gvsolgryn/HYK_AMP_Converter/docs/DUDU7_i40_SPDIF_TX_Rev1_PCB_Mechanical_Handoff_20261113.md

# DUDU7 / FYT7862 → Hyundai i40 S/PDIF TX Rev.1
## PCB · 기구 인계 문서 — 2026-11-13

다음 에이전트가 이 문서와 `AGENTS.md`만 읽고 PCB 작업을 시작할 수 있도록 정리한 문서다.
설계 판단의 최우선 기준은 여전히 `docs/DUDU7_i40_SPDIF_TX_Rev1_BOM_for_KiCad_Agent.md` §9 Decision log다. 이 문서와 충돌하면 Decision log가 우선이다.

---

## 1. 현재 상태 한눈에 보기

| 항목 | 상태 |
|---|---|
| 회로도 | Rev.1 부품 54개 배치·배선 완료, **ERC 0건**, 넷리스트 핀 단위 대조 일치 |
| 레이아웃 | 4개 블록(1 POWER / 2 INPUT / 3 DRIVER / 4 OUTPUT) 점선 프레임, 블록 간 로컬 라벨 |
| 커넥터 핀 | J3 `1=ACC_IN, 2=GND` (결정 #15) · J2 `1=SPDIF−, 2=SPDIF+, 3=GND` (결정 #23) |
| 외함 | **케이스포유 RT-7511** (75 × 30.9 × 110 mm) — 결정 #16, 치수는 §3 |
| BNC 장착 | J1을 PCB 앞 가장자리에 두고 **나사부를 앞판 구멍으로 빼서 너트로 고정** — 결정 #17 |
| PCB | **배치·배선 완료**, DRC 0 · 회로도 불일치 0 (결정 #24). §5 체크리스트 참고 |
| 커밋 | 2026-11-13 PCB 작업까지 커밋·푸시 (case 도면은 저작권 때문에 제외, §3.4) |

---

## 2. 2026-11-13 세션에서 바뀐 것 (시간순)

1. README를 Rev.1 기준으로 재작성. `opencode.json` 삭제(OpenCode 미사용).
2. MCP 서버를 **mixelpixx/KiCAD-MCP-Server v2.9.0**으로 교체. `~/MCP/KiCAD-MCP-Server`에 설치, omp 사용자 설정 `~/.omp/agent/mcp.json`에 `KICAD_MCP_OPERATING_MODE=readonly`로 등록. 등록 방법은 README "MCP 자동화".
3. 배선 가이드(HTML·MD)를 결정 로그와 맞춤: `L1→FL1`, `+3V3→+3.3V`, D1 `1=K/2=A`, FL1 핀 `1↔4 / 2↔3`, R6 `CMP_OUT↔SPDIF_AC` DNP. ASCII 그림을 새로 그리고 넷 라벨을 `[NET]` 표기로 통일.
4. **D2 TVS를 D1 앞(`ACC_FUSED`)으로 확정** — 결정 #14.
5. 사용자가 회로도 배선 완료 → 넷리스트 대조로 검증.
6. ERC 수정: U2(TPS7B8350 심볼) 핀 타입 `IN/GND=power_in, OUT=power_out`, U4(MAX3295 심볼) `DI/DE=input, Y/Z=output`. 라이브러리 파일과 회로도 내장 캐시 둘 다 수정. PWR_FLAG `#FLG01`(VIN_PROTECTED), `#FLG02`(GND).
7. 회로도 레이아웃 정리(와이어·라벨 재작성, 넷리스트 동일 확인).
8. J2/J3 핀 순서를 "이름 순서, GND 마지막"으로 변경 — 결정 #15.
9. 외함을 Hammond 1455C1201BK → **케이스포유 RT-75(RT-7511)**로 변경 — 결정 #16.
10. BNC를 앞판 관통 고정 방식으로 정함 — 결정 #17.

백업(깃 미포함, `backup/` 로컬): `20261113_011734`(배선 직후) · `20261113_012318`(사용자 최종 수정) · `20261113_012744`(ERC 수정 후) · `20261113_014944`(레이아웃 정리 후).

---

## 3. 외함 — 케이스포유 RT-75 (RT-7511)

출처: 케이스포유 도면 `RT-7511.pdf / .dwg / .STEP` (2011-07-27, 사용자가 `references/case_file/RT_7511.zip`, `RT_7590.zip`으로 보관). 아래 치수는 도면 숫자를 그대로 옮기거나(■) 도면 축척으로 계산한 값(□)이다.

### 3.1 외형

| 항목 | 값 | 출처 |
|---|---|---|
| 전체 | 75 (W) × 30.9 (H) × 110 (L) mm | ■ |
| 본체(압출, AL6061, 아노다이징) | 74.9 × 30.5 × **107** mm | ■ |
| 전·후면 판넬(AL5052, 아노다이징) | 75 × 30.9 × **1.5** mm, 본체 양 끝에 볼트 체결 | ■ |
| 판넬 나사 구멍 | 4개, 중심 간격 **67.2 (가로) × 22.8 (세로)**, 판넬 중앙 기준 대칭 | ■ |
| RT-7590 | 같은 단면, 본체 87 mm, 전체 90 mm | ■ |

### 3.2 PCB 장착 단면 (RT-7511 단면도)

```text
          ┌──────────────── 75 ────────────────┐
     ─ ─  ╭──◎────────────────────────────◎──╮   ◎ = 판넬 나사 보스(코너 4개, 67.2 × 22.8)
     ↑    │                                    │
     │    │        PCB 위 여유 ≈ 19.4 mm □      │  25.5 = 내부 높이 ■
 30.9│    │                                    │
     │  ══╪════════════ PCB 1.6T ═════════════╪══ 홈 간격 1.70 ■ / 홈 바닥 간 폭 70.5 (STEP) · 내벽 69.7 ■
     │    │        PCB 아래 4.5 mm ■            │
     ↓    ╰──◎────────────────────────────◎──╯
```

| 항목 | 값 | 출처 |
|---|---|---|
| PCB 두께 | 1.6 mm (홈 1.70) | ■ |
| PCB 폭 한계 | **홈 바닥 간 70.5 mm** (STEP 실측, 홈 깊이는 내벽에서 2.0 mm). 도면의 69.7은 PCB 위쪽 **내벽 간 폭**. 케이스포유 PCB 참고도는 70.00 × 107.00 | ■ STEP |
| **PCB 외형** | **69.5 × 100.0 mm** (홈 바닥 70.5 대비 양쪽 0.5 mm 여유, 홈 물림 1.5 mm. 길이는 JLCPCB 특가 한도 102 mm 이하 — 107로 하면 추가금) | 결정 #18 (#16의 107.0 대체) |
| PCB 아래면 ↔ 내부 바닥 | **4.5 mm** | ■ |
| 내부 높이 | 25.5 mm | ■ |
| PCB 윗면 위 여유 | 내부 천장까지 **19.35 mm** (중앙부) | ■ STEP |
| PCB 윗면 높이(외부 바닥 기준) | **8.65 mm** (외부 바닥 −15.0, PCB 윗면 −6.35, STEP 좌표) | ■ STEP |

**STEP 실측 (2026-11-13, `RT-7511.STEP` 단면, PCB를 홈 중앙 −7.95 ~ −6.35에 둔 기준)**. d = PCB 긴 변에서 안쪽으로 잰 거리.

| 구역 | 범위 | 제약 |
|---|---|---|
| 홈 물림 | d < **1.5 mm** (양쪽) | PCB가 홈에 들어가는 부분. 부품·노출 동박 금지. 구리–가장자리 클리어런스 **2.0 mm 권장** (홈 안 알루미늄과 접촉 방지) |
| 윗면 홈 턱 | d < 1.5 mm는 높이 1.55 mm까지, d < 0.9 mm는 2.55 mm까지 벽 | 위 홈 물림 금지로 해결 |
| 윗면 나사 보스 | d < **3.9 mm** | 부품 높이 **≤ 15.2 mm** (보스 하단 = PCB 위 15.25 mm). 그 안쪽은 19.35 mm |
| 아랫면 홈 턱 | d < 1.5 mm | 홈 아래 면 (PCB가 얹힘) |
| 아랫면 나사 보스 | d < 2.35 mm → 리드 돌출 **≤ 1.8 mm**, d < 3.9 mm → **≤ 3.0 mm** | 그 안쪽은 바닥까지 4.55 mm |

KiCad 참조: 풋프린트 `Case_RT75:CASE_RT7511` (패드 없음, board-only, BOM 제외). 기판 앞 가장자리 중앙에 0°로 두면 3D 뷰어에 케이스가 겹쳐 보이고, `Dwgs.User`에 판넬 위치·홈 1.5 mm(점선)·보스 3.9 mm(점선)가 그려진다. STEP 경로는 `${KIPRJMOD}/references/case_file/RT_7511/RT-7511.STEP`(로컬 전용).

### 3.3 PCB 설계 제약 (외함에서 나온 것)

- **길이 100 mm (본체 107 mm보다 7 mm 짧음)**: PCB **앞 가장자리를 본체 앞끝에 맞추고**(J1 나사부가 앞판 관통, 결정 #17), 뒤쪽 약 7 mm는 뒷판까지 빈 공간으로 둔다. PCB는 홈과 J1 판넬 너트로 위치가 정해지므로 뒤가 떠 있어도 된다. 이 공간은 J2·J3 플러그·전선용으로 쓴다.
- **아래면**: Bottom에 부품 없음(전 부품 Top 규칙 유지). THT 리드는 **1.5 mm 이하로 자르면 모든 위치에서 안전** (긴 변 3.9 mm 이내는 위 표 제약).
- **긴 변**: 부품 코트야드는 긴 변에서 **2.0 mm 이상**, 높이 15.2 mm 초과 부품(현재 없음)은 3.9 mm 이상 떨어뜨린다. 현재 가장 높은 부품: J1 12.5, F1+퓨즈 ≈ 13, C1 11 mm.
- **높이 예산 19.4 mm**: BNC, 퓨즈홀더+퓨즈, TSR 모듈, VH 커넥터, C1 전해(세워서 6.3×11 가정)의 실제 높이를 각 데이터시트로 확인하고 3D(STEP)로 간섭 검사.
- 3D 확인: `Case_RT75:CASE_RT7511` 풋프린트를 배치하고 3D 뷰어(Alt+3)에서 본다. 뚜껑이 닫힌 모델이라 안쪽은 반투명 설정이나 단면으로 확인.
- **J1 앞판 구멍**: 중심 = 외부 바닥에서 **19.65 mm**(PCB 윗면 8.65 + BNC 축 11.0), 가로는 J1 위치(기판 긴 변에서 20 mm → 판넬 세로 중심선에서 14.75 mm). 판넬 나사 구멍(67.2 × 22.8)과 간섭 없음.

### 3.4 도면 파일과 저작권

- 케이스포유 도면에 "무단복제·전재·발췌 시 저작권법 저촉" 문구가 있고, 이 저장소는 **공개(public)** 상태다.
- 그래서 `references/case_file/`는 **`.gitignore`로 제외**했다. 사용자 PC에만 있다. 다른 PC에서는 **[케이스포유 자료실 · RT-75 TYPE PDF·DWG·STEP](https://www.case4u.co.kr/board/free/read.html?no=1060&board_no=7)** 에서 받는다 (RT-7511·RT-7590 포함, 회원 로그인이 필요할 수 있음). 받은 zip은 `references/case_file/`에 둔다.
- 치수(사실 정보)만 이 문서에 기록했다.
- PDF를 이미지로 보려면 KiCad 내장 Python의 PyMuPDF를 쓴다 (MCP 설치 때 함께 설치됨):
  ```bash
  "/c/Program Files/KiCad/10.0/bin/python.exe" -c "import pymupdf as f; d=f.open('RT-7511.pdf'); d[0].get_pixmap(dpi=300).save('p1.png')"
  ```

---

## 4. J1 BNC — Kinghelm KH-BNC75-3511

`references/datasheets/KH-BNC75-3511.pdf` (도면 해상도가 낮아 □ 표시 값은 풋프린트 제작 때 재확인).

| 항목 | 값 |
|---|---|
| 형식 | **직각 PCB 실장 + 패널 관통(벌크헤드)**: 1/2-28UNEF-2A 나사부, 와셔, 육각 너트 포함 |
| 정격 | 75 Ω, DC~3 GHz, VSWR ≤ 1.3 |
| 몸체 | 폭 14.7 mm, 전체 길이 35.5 mm REF, 기타 28.5±0.4 / 21.0±0.3 (기준면 재확인 필요) □ |
| 중심축 높이 | PCB 위 약 11 mm □ |
| PCB 패턴 | 고정 다리 Ø2.0 × 2 (간격 약 10.1), 신호·GND 핀 Ø0.9 × 2 (간격 약 2.5) □ |
| 판넬 구멍 | Ø12.8 원에 회전 방지 직선부가 있는 D형 □ |
| 심볼 핀 | `1=In`(중심, `COAX_SPDIF`), `2=Ext`(쉴드, 넷 `/SHIELD` → R17 0Ω ∥ C15 DNP → GND, 결정 #25) |
| 풋프린트 | `KH-BNC75-3511:KH-BNC75-3511` (결정 #19) |

### 4.1 장착 방식 (결정 #17)

- J1을 PCB **앞 가장자리**에 두고, 나사부가 PCB 앞 가장자리 밖으로 나와 **앞판(1.5 mm)을 관통**한 뒤 바깥에서 와셔·너트로 고정.
- 케이블 장력은 판넬 너트가 받고, PCB 납땜부에는 거의 가지 않는다. 피그테일 없음.
- 판넬 구멍 중심 높이(외부 바닥 기준) ≈ PCB 윗면 8.8 + 축 높이 약 11 ≈ **19.8 mm** □. 판넬 높이 30.9 안에 들어가고, 판넬 나사 구멍(67.2 × 22.8)과는 J1을 가로 중앙 근처에 두면 겹치지 않는다.
- 조립 순서: 앞판을 BNC 나사부에 끼우고 너트 고정 → PCB와 앞판을 함께 본체 홈에 밀어 넣기 → 앞판 볼트 → 뒷판 볼트.
- D형 직선부 방향을 PCB 기준으로 정해 판넬 가공 도면에 표시.

### 4.2 접지 정책 (결정 #25, 2026-11-13)

- 나사부가 판넬에 닿으면 BNC 쉴드와 케이스가 연결된다. **아노다이징 피막은 절연**이라 그대로 두면 접촉이 불안정하다.
- **채택**: 구멍 주변 피막을 벗기고 톱니 와셔로 **케이스를 쉴드에 확실히 연결**, **케이스는 차체에 닿지 않게**(벨크로·절연 브래킷) 고정해 GND가 J3 한 곳으로만 차체에 연결되게 한다.
- 회로: J1 쉴드(패드 2 세 개)는 넷 `/SHIELD`. **R17 0Ω(실장)** 으로 GND에 연결, **C15(TBD, DNP)** 는 병렬 자리. 실차에서 잡음·그라운드 루프가 생기면 R17을 빼고 C15를 실장한다. R17·C15는 J1 오른쪽, 각 GND 패드 옆에 GND via.

---

## 5. PCB 진행 상황 (2026-11-13)

| # | 항목 | 상태 |
|---|---|---|
| 1 | 기판 설정: 2층 1.6 mm, Edge.Cuts 69.5 × 100.0 R1, 원점 (50, 30.5), JLCPCB 규칙, 구리–가장자리 2.0 mm, 넷 클래스 Power12/Rail/GND/SPDIF_OUT | ✅ 결정 #24 |
| 2 | J1 전용 풋프린트, C1·J2·D1·F1 풋프린트 확정 | ✅ 결정 #19~#21 |
| 3 | Update PCB from Schematic, 배치(신호 위 · 전원 아래), 배선 | ✅ 사용자 배선 + EMI 정리 |
| 4 | GND: Top·Bottom 전면 GND, 열 릴리프 0.5, GND via(패드 옆 + 10 mm 격자) | ✅ |
| 5 | 케이스 참조 `MECH1` (3D + 홈·보스·판넬 선) | ✅ |
| 6 | 실크: DNP 표시, J2 `SP- SP+ GND`·J3 `ACC GND`(핀 열 뒤쪽), 극성 매트릭스 주의 문구, `S/PDIF COAX IN`·`12V ACC IN`, 보드 이름 `HYK S/PDIF TX Rev.1 2026-11`. C1 `+`·D1 띠는 풋프린트 기본 | ✅ |
| 7 | 3D 간섭 확인 (케이스 반투명) | ⏳ |
| 8 | BOM 품번(MLCC·저항 12종, U/D/J 필드) | ⏳ |
| 9 | 사용자 최종 검토 → **Gerber·발주는 사용자 승인 후** (AGENTS 작업 규칙 3) | ⏳ |
| 10 | 시제품 맞춤 확인 **후** 판넬 가공(앞판 BNC D형 구멍, 뒷판 그로밋)·레이저 마킹 | ⏳ |

배치·배선 원칙(§8.1)과 실제 결과: J1 → R1 → C9 → U3 최단, C7·C8은 U3·U4 VCC에서 1.9·2.8 mm, C2는 U1 Vin에서 5 mm, Bottom GND 면에 신호 트랙 없음, SPDIF 출력 경로 전부 Top, TSR 모듈 아래 배선 없음. 조립 후 시험은 §8.2 순서(미통전 → 전원만 → 신호 → AMP).

---

## 6. 아직 정하지 않은 것 (사용자 결정 필요)

| 항목 | 선택지 / 권장 |
|---|---|
| 케이스 접지 | ✅ 결정 #25 (§4.2) |
| C9→U3 IN+ 직렬 0Ω 자리 (ESD 대비) | 미답변 |
| TSR 입력 인덕터 0Ω 자리 (AM 대역 EMI 대비) | 미답변. Rev.1 BOM은 "입력 LC 필터 추가 안 함" |
| 뒷판 하네스 출구 | 그로밋 1개 + 내부 J2/J3 (권장) / 판넬 노출 커넥터 |
| 케이스 고정 | 벨크로·양면테이프 + 케이블타이 / L브래킷. 이전 계획(Rev.A2)은 "순정 AMP 위에 3M 차량용 내열 양면테이프" |
| J2 XH 실물 | 정품 JST `S3B-XH-A`(2.50 mm) 구매 확정 필요 (풋프린트는 정품 기준, 드릴 1.0) |
| MLCC·저항 MPN | 미정 (12종) |
| U/D/J `Manufacturer`·`MPN` 필드 | 미입력 (C1·F1·FL1은 완료, 결정 #20·#22) |

---

## 7. 도구·환경 메모

- KiCad 10.0.8, `kicad-cli` = `C:/Program Files/KiCad/10.0/bin/kicad-cli.exe`
- ERC: `kicad-cli sch erc --format json --severity-all --output <TEMP>/erc.json HYK_AMP_Converter.kicad_sch`
- 넷리스트 대조: `kicad-cli sch export netlist --format kicadxml --output <TEMP>/net.xml ...` 후 넷별 `ref.pin` 목록 비교
- 회로도 SVG: `kicad-cli sch export svg --exclude-drawing-sheet --output <TEMP>/svg ...`
- MCP: mixelpixx `readonly` 기본. PCB/회로도 쓰기 전 `write`로 전환하고 끝나면 되돌림. 회로도는 KiCad에서 열려 있으면 편집 거부됨.
- 회로도 파일은 **CRLF 줄바꿈**. 텍스트로 수정할 때 유지할 것.
- A4 타이틀 블록 영역(회로도 x > 177 mm, y > 166 mm)은 비워 둠.

---

## 8. 이전 문서에서 가져온 유효 내용

옛 문서(`docs/archive/`)는 기본적으로 읽지 않는다. 아래는 그중 Rev.1에도 여전히 유효한 내용만 옮긴 것이다. 출처 표기는 `archive/…RevA2…` 기준.

### 8.1 PCB 배치·배선 원칙 (Rev.A2 §7을 Rev.1에 맞게 수정)

- 2층 FR4, **전 부품 Top**, Bottom은 연속 GND plane. **GND plane을 불필요하게 분할하지 않는다.**
- 스위칭 전원(TSR 1 모듈)과 C1·C2 입력 루프는 짧게. 민감한 **BNC 입력과 1.65V VREF 망에서 멀리** 배치.
- 75Ω 종단(R1) → AC 결합(C9) → 바이어스(R2) → U3 경로는 짧게, 신호 GND 리턴 확보.
- MAX3295 → 120Ω × 2 → 극성 매트릭스 → CMC → 출력 차동 경로는 **짧고 대칭**.
- 케이스는 스스로 방열판이 아님. LDO(U2) GND 탭에 구리 면적·thermal via.
- 케이스·PCB Bottom 구리·핀·실드가 의도치 않게 단락되지 않도록 절연 고려(§3.3 아래 4.5 mm).
- 5 m 동축과 AMP 하네스의 장력은 케이스/차체로 분산(BNC는 판넬 너트, 하네스는 그로밋·케이블타이).
- 극성 매트릭스의 **기본 2개 실장 / 4개 동시 실장 금지**를 실크·조립도에 표기.

### 8.2 제작·시험 게이트 (Rev.A2 §10)

KiCad 쪽 순서: 데이터시트 핀·정격 확인 → 회로도 → ERC → 넷리스트/핀맵 검증 → BOM/풋프린트 확정 → **사용자 회로도 리뷰** → 케이스 치수 → PCB → DRC → 3D 충돌 검사 → Gerber/Drill → **발주 전 사용자 최종 승인**.

| 단계 | 장비 | 확인 사항 |
|---|---|---|
| PCB 미통전 | Fluke 101 | +3.3V–GND, +5V–GND 단락 없음 · 0Ω 점퍼 조합 · 부품값 · 전원/신호 오접속 |
| 전원만 | 전류제한 DC 전원 + Fluke | +5V, +3.3V, 소비전류, 전원부 과열 |
| 전원 리플/기동 | 오실로스코프 권장 | +5V 리플(TSR 500 kHz), +3.3V 품질 |
| 신호 입력 | 오실로스코프 필요 | DUDU7 출력을 75Ω 종단한 상태의 Vpp, 에지, 반사·잡음 |
| 비교기 | 오실로스코프 필요 | VREF, CMP_OUT BMC 파형, 지터·오검출·고정 HIGH/LOW |
| MAX3295 출력 | 오실로스코프 필요 | Y/Z 극성, 최종 차동 전압(56Ω + AMP 병렬 부하) |
| EMI | 실차 기능시험 | 출력 EMI 커패시터 DNP vs 실장, 라디오(AM) 간섭, 음 끊김 |
| 차량 OFF | 전원·암전류 | ACC가 실제 0V, BNC/AMP 쪽 역급전 없음, IBS 휴지 상태 방해 없음 |
| 열/진동 | 장시간 주행·고온 | 전원부·케이스 온도, 동축 장력, 고정 상태 |

### 8.3 계측 한계와 안전 (Rev.A2 §10.2)

- 사용자 계측 장비는 **Fluke 101 멀티미터뿐**. 10~100 pF MLCC 측정, S/PDIF 파형, 차동 신호 품질 확인에는 부족 → 오실로스코프 확보 또는 외부 계측 필요.
- Raspberry Pi Pico 2 로직애널라이저는 **미구입**. 아날로그 동축 신호(약 0.5 Vpp)를 3.3V GPIO에 직결 금지.
- AMP 연결 전 전원·출력·배선 확인 선행. **ACC 12V가 AMP SPDIF 신호선에 들어가는 오배선 절대 금지.**

### 8.4 OEM 분석에서 남은 사실 (Rev.A2 §2)

- 순정 AVN 출력단 실측: Y/Z 직렬 120Ω(R419/R420), F400 4단자(2라인 CMC 추정, 경로 DC 약 1Ω), AMP 쪽 차동 56Ω(R423). Rev.1 출력 토폴로지가 이를 복제함.
- OEM C593/C433/C430/C431 값은 **미측정·복제 금지** → Rev.1 C11~C14 `TBD`, DNP.
- **SPDIF−는 GND가 아니다.** AMP 커넥터 핀 배열은 실차 배선으로 직접 확인.
- AMP 입력 임피던스·내부 종단·허용 레벨은 미확인 (§6 미결, 미완료 검증).
