gvsolgryn/HYK_AMP_Converter/docs/DUDU7_i40_SPDIF_TX_Rev1_Schematic_Placement_and_Wiring.html

## 작업 목차

# DUDU7 / FYT7862 → Hyundai i40

## S/PDIF TX Rev.1 — KiCad 심볼 배치·핀 연결 가이드

기준일 2026-11-11 · 결정 로그 반영 2026-11-13 · 기준 문서 docs/DUDU7_i40_SPDIF_TX_Rev1_BOM_for_KiCad_Agent.md (§9 Decision log 우선)

54개 배치 심볼 R1~R16 C1~C14 TP1~TP13 회로도 작업용 · 제조 승인 아님

작업 순서: U1~U4 번호 통일 → 전원부 → 입력부 → MAX3295 → 출력부 → 테스트포인트 → 수동 점검·ERC

체크 상태는 이 HTML을 연 브라우저의 로컬 저장소에 저장됩니다. 다른 브라우저나 파일 복사본에서는 체크 상태가 공유되지 않을 수 있습니다.

회로도 실제 이름 (결정 로그 §9): CMC는 문서의 logical ref L1이 아니라 FL1, 3.3V 전원 넷은 +3.3V(power:+3.3V)입니다. +3V3 라벨을 따로 만들지 마세요. TP3 Value +3.3V_TP는 표시용입니다.

부품·테스트포인트 배치 진행률0 / 54

0 / 54

배선도 전체 펼치기 인쇄 / PDF 체크 초기화

## 0. 참조 번호를 먼저 통일

기존 Rev.A2 회로도와 U1~U4의 기능이 다릅니다. 기존 부품을 그대로 두고 Rev.1 부품을 추가하지 말고, 아래 번호로 먼저 변경하거나 새 회로도에서 시작하세요.

기능 | Rev.A2 | Rev.1
5V DC/DC | U4 LMR16006YQ5 | U1 TSR 1-2450
3.3V LDO | U1 TPS7B8333 | U2 TPS7B8333
Comparator | U2 TLV3601 | U3 TLV3601
차동 드라이버 | U3 MAX3295 | U4 MAX3295

이 문서는 Rev.1 logical reference에 실제 KiCad 참조 번호를 배정한 작업 가이드입니다. 선정 MPN과 FIT/DNP를 임의로 바꾸지 않습니다. 커넥터와 CMC의 물리 패드 번호는 실제 부품 도면으로 확인하기 전까지 확정하지 않습니다.

## 1. 배치할 심볼 체크리스트

각 부품을 KiCad에 배치하고 값·실장 상태를 확인한 뒤 체크하세요. 체크하면 행이 흐려지고 상단 진행률에 반영됩니다.

### 1.0 KiCad 공용 심볼 사용 방법

정확한 제조사 심볼이 없어도 회로도는 그릴 수 있습니다. 심볼 모양·핀 번호, Value의 실제 MPN, Footprint의 실제 패키지를 따로 선택하면 됩니다. 공용 심볼을 사용했다는 이유로 Value를 Diode, 1.5KExxCA, Conn_01x03 같은 일반 이름으로 두면 안 됩니다.

대상 | 사용할 심볼 | 사용 방법
U1 | Converter_DCDC:TSR_1-2450 | KiCad 공용 정확형 심볼이 있으므로 그대로 사용 가능. 1=VIN, 2=GND, 3=VOUT 확인 완료. 현재 공용 심볼과 기본 TSR-1 풋프린트 조합 사용 가능.
U2 | TPS7B8350QDCYRQ1:TPS7B8350QDCYRQ1 | 핀맵 재사용 가능. Value는 반드시 TPS7B8333QDCYRQ1. Footprint는 TPS7B8350QDCYRQ1:SOT_8350QDCYRQ1_TEX-L. 1=IN, 2=GND, 3=OUT, 4=GND.
U3 | symbols:TLV3601QDBVRQ1 | 검증된 프로젝트 심볼 사용. 1=OUT, 2=GND, 3=IN+, 4=IN−, 5=VCC.
U4 | symbols:MAX3295AUT_V+T | 동일 핀맵 재사용 가능. Rev.1 Value는 반드시 MAX3295AUT+T로 변경. Y=6, Z=4.
D1 | Device:D | 1=K, 2=A — 풋프린트 SB360:P2_DO-201 패드1(사각·띠)=K와 일치 (결정 로그 #11). 1=A인 심볼을 쓰면 PCB에서 D1이 뒤집힙니다. Value SB360.
D2 | Diode:1.5KExxCA 또는 Device:D_TVS | 둘 다 양방향 TVS에 사용 가능. Value는 정확히 1.5KE22CA로 변경. 현재 Diode_THT:D_DO-201AE_P15.24mm_Horizontal 사용 가능.
F1 / FH1 | 3557-2:3557-2 | F1 심볼 하나로 표현 (결정 로그 #4). 1_1+1_2를 함께, 2_1+2_2를 함께 배선. Footprint FUSE_3557-2:FUSE_3557-2. 퓨즈 인서트 0891002.NXS는 MPN 필드에 기록.
FL1 | ACM2012H-900-2P-T00:ACM2012H-900-2P-T00 | Value ACM2012-900-2P-T001 (H/non-H 동일 치수). Line1 = 1↔4, Line2 = 2↔3 (TDK Circuit Diagram, 무극성). Footprint ACM2012H-900-2P-T00:ACM20121022PT001.
J1 | Connector:Conn_Coaxial | Value KH-BNC75-3511. 1=In(CENTER), 2=Ext(SHIELD). 실제 BNC 풋프린트는 PCB 단계에서 확정.
J2 | Connector_Generic:Conn_01x03 | 1=SPDIF−, 2=SPDIF+, 3=GND (결정 로그 #23). Value는 실제 구매한 XH 커넥터 MPN으로 변경하고 pitch 확인.
J3 | Connector_Generic:Conn_01x02 | Value JST B2PS-VH. 1=ACC_IN, 2=GND (결정 로그 #15).
C1 | Device:C_Polarized | 극성 전해커패시터 심볼. Value 22uF/50V, 실제 MPN·직경·리드 간격은 구매 부품으로 확정.
C2~C14 | Device:C | 일반 커패시터 심볼. 각 행의 값과 FIT/DNP를 그대로 적용하고 0805 풋프린트 지정.
R1~R16 | Device:R | 일반 저항 심볼. 각 행의 값·FIT/DNP 적용. 0805 풋프린트 지정.
TP1~TP13 | Connector:TestPoint | 공용 테스트포인트 심볼. 각 행의 Net 이름으로 연결.
전원 | power:+5V, power:+3.3V, power:GND | 공용 전원 심볼 사용. PWR_FLAG는 ERC에서 전원 공급 오류가 발생하는 위치에만 추가.

새로 받은 프로젝트 심볼도 그대로 사용할 수 있습니다. TSR과 3557-2 심볼의 기본 Footprint 필드는 프로젝트 닉네임인 CONV_TSR_1-2450, FUSE_3557-2에 맞췄습니다. U1은 공용 정확형 심볼이 이미 있으므로 굳이 프로젝트 심볼로 교체할 필요는 없습니다.

### 1.1 IC·보호부품·CMC·커넥터

현재 회로도 상태 (2026-11-13): 54개 전부 배치 완료. U4 MAX3295AUT+T, D2 1.5KE22CA, F1 Footprint FUSE_3557-2:FUSE_3557-2, D1 Device:D(1=K) 반영됨. 남은 필드 정리: F1 Value/MPN(현재 3557-2[Fuse_Holder], MPN=3557-2, Fuse_MPN=0891002.nxs).

완료 | Ref | 심볼 / 값 | 실장 | 비고
| U1 | TSR 1-2450 | FIT | 12V→5V 모듈, SIP-3
| U2 | TPS7B8333QDCYRQ1 | FIT | 5V→3.3V LDO, SOT-223
| U3 | TLV3601QDBVRQ1 | FIT | Comparator, SOT-23-5
| U4 | MAX3295AUT+T | FIT | 차동 드라이버, SOT-23-6
| D1 | SB360 | FIT | 직렬 역극성 보호 Schottky
| D2 | 1.5KE22CA | FIT | 양방향 TVS, ACC_FUSED ↔ GND 병렬 (D1 앞)
| F1 | 0891002.NXS, 2A | FIT | LP Mini 블레이드 퓨즈
| FL1 | ACM2012-900-2P-T001 | FIT | 2채널 CMC (Line1 1↔4, Line2 2↔3)
| J1 | KH-BNC75-3511 | FIT | 75Ω BNC 입력
| J2 | 3핀 XH 계열 | FIT | SPDIF+ / SPDIF− / GND, 정확한 MPN 미정
| J3 | JST B2PS-VH | FIT | ACC 12V / GND 전원 입력

FH1 = Keystone 3557-2는 F1의 PCB 홀더입니다. 퓨즈와 홀더를 각각 직렬로 배선하지 말고 F1 하나로 표현하고 FH1 풋프린트를 연결하세요. VHR-2N 하우징과 SVH-21T-P1.1 크림프는 회로도 심볼이 아닙니다.

### 1.2 커패시터 C1~C14

일반 MLCC는 0805 imperial = 2012 metric입니다.

완료 | Ref | 값 | 실장 | 연결 위치
| C1 | 22µF / 50V 전해 | FIT | D1 이후 VIN_PROTECTED ↔ GND
| C2 | 100nF / 50V X7R | FIT | VIN_PROTECTED ↔ GND
| C3 | 10µF / 16V X7R | FIT | U1 5V 출력 +5V ↔ GND
| C4 | 1µF / 16V X7R | FIT | U2 입력 +5V ↔ GND
| C5 | 10µF / 16V X7R | FIT | U2 출력 +3.3V ↔ GND
| C6 | 10µF / 16V X7R | FIT | C5와 병렬, +3.3V ↔ GND
| C7 | 100nF / 16V X7R | FIT | U3 VCC 국소 디커플링
| C8 | 100nF / 16V X7R | FIT | U4 VCC 국소 디커플링
| C9 | 10nF / 50V X7R | FIT | 입력 AC coupling, C_AC
| C10 | 1µF / 16V X7R | FIT | VREF ↔ GND, C_REF
| C11 | TBD | DNP | Pre-CMC 차동선 사이, C_EMI_PRE
| C12 | TBD | DNP | Post-CMC SPDIF_P ↔ SPDIF_N, C_EMI_POST
| C13 | TBD | DNP | SPDIF_P ↔ GND, C_EMI_PGND
| C14 | TBD | DNP | SPDIF_N ↔ GND, C_EMI_NGND

### 1.3 입력부 저항 R1~R6

완료 | Ref | Logical ref | 값 | 실장 | 연결
| R1 | R_TERM | 75Ω / 1% | FIT | COAX_SPDIF ↔ GND
| R2 | R_BIAS | 2.2kΩ / 1% | FIT | SPDIF_AC ↔ VREF
| R3 | R_REF1 | 2.2kΩ / 1% | FIT | +3.3V ↔ VREF
| R4 | R_REF2 | 2.2kΩ / 1% | FIT | VREF ↔ GND
| R5 | R_OUT | 0Ω | FIT | U3 OUT → U4 DI, 필요 시 22Ω
| R6 | R_HYS | TBD | DNP | U3 OUT(CMP_OUT) ↔ U3 IN+(SPDIF_AC) 자리만, 값 미설계

R6은 DNP · Value TBD입니다. 결정 로그 #8에 따라 CMP_OUT ↔ SPDIF_AC(OUT→IN+)로 그려 둘 수 있습니다. 0Ω 실장 금지 — OUT과 IN+가 직결되면 비교기가 래치되어 신호가 사라집니다. 값은 무입력 발진이 실측될 때만 계산합니다.

### 1.4 MAX3295 출력부 저항 R7~R16

완료 | Ref | Logical ref | 값 | 실장 | 연결
| R7 | R_SER_Y | 120Ω / 1% | FIT | U4 Y(6) → 극성 선택기
| R8 | R_SER_Z | 120Ω / 1% | FIT | U4 Z(4) → 극성 선택기
| R9 | R_DIFF | 56Ω / 1% | FIT | CMC 뒤 SPDIF_P ↔ SPDIF_N
| R10 | R_POL_YPLUS | 0Ω | FIT | Y 경로 → CMC 채널1
| R11 | R_POL_ZMINUS | 0Ω | FIT | Z 경로 → CMC 채널2
| R12 | R_POL_YMINUS | 0Ω | DNP | Y 경로 → CMC 채널2
| R13 | R_POL_ZPLUS | 0Ω | DNP | Z 경로 → CMC 채널1
| R14 | R_CMC_BYPASS1 | 0Ω | DNP | CMC 채널1 입력↔출력 우회
| R15 | R_CMC_BYPASS2 | 0Ω | DNP | CMC 채널2 입력↔출력 우회
| R16 | R_DE | 0Ω | FIT | +3.3V → U4 DE(3)

기본은 R10+R11만 실장입니다. R12/R13까지 함께 실장하면 차동 출력이 단락될 수 있습니다. R14/R15는 FL1을 제거할 때만 대체 실장합니다.

### 1.5 테스트포인트 TP1~TP13

완료 | Ref | Net | 측정 위치
| TP1 | VIN_PROTECTED | 퓨즈·보호 이후 12V
| TP2 | +5V | U1 5V 출력
| TP3 | +3.3V | U2 3.3V 출력
| TP4 | GND | 기준 접지
| TP5 | COAX_SPDIF | BNC 동축 입력
| TP6 | SPDIF_AC | U3 IN+
| TP7 | CMP_OUT | U3 OUT
| TP8 | DI | U4 DI
| TP9 | DE | U4 DE
| TP10 | Y_RAW | U4 Y
| TP11 | Z_RAW | U4 Z
| TP12 | SPDIF_P | 최종 SPDIF+
| TP13 | SPDIF_N | 최종 SPDIF−

### 1.6 부품 번호가 없는 회로도 심볼

- 전원 심볼: +5V, +3.3V, GND
- Net 라벨: ACC_IN, ACC_FUSED, VIN_PROTECTED, COAX_SPDIF, SPDIF_AC, VREF, CMP_OUT, DI, DE, Y_RAW, Z_RAW, SPDIF_P, SPDIF_N
- CMC 입력 측 보조 라벨: PAIR_P, PAIR_N
- PWR_FLAG: ERC 전원 공급 오류가 나오는 위치에만 추가
- DNP 및 점퍼 조합을 설명하는 텍스트 노트

배치 수량: IC·다이오드·퓨즈·CMC·커넥터 11 + 커패시터 14 + 저항 16 + 테스트포인트 13 = 54개
DNP는 R6, R12~R15, C11~C14입니다.

## 2. 전원부 핀 연결

그림 읽는 법: [ACC_IN]처럼 대괄호 = 넷 라벨(이름은 1.6 목록과 동일) · 대괄호 없는 GND = 전원 심볼 · 박스 안 숫자와 pin N = 심볼 핀 번호 · ├──/└── = 같은 넷 분기 · ← 뒤 = 설명 · FIT DNP
J2·J3의 ACC, SPDIF+ 같은 박스 안 이름은 커넥터 핀 이름이고 넷 이름이 아닙니다(핀 배정: J3 1=ACC·2=GND, J2 1=SPDIF+·2=SPDIF−·3=GND, GND는 항상 마지막). J1(1=In, 2=Ext)과 FL1(1↔4, 2↔3)은 확인 완료.

2.1 ACC 12V 입력·보호·U1 5V 모듈

J3  JST B2PS-VH                  ← 결정 로그 #15: 이름 순서, GND 마지막
┌─────────┐
│ 1  ACC  ├──── [ACC_IN]          ← 빨강
│ 2  GND  ├──── GND               ← 검정
└─────────┘

F1  0891002.NXS 2A  (홀더 Keystone 3557-2, 1_1+1_2 / 2_1+2_2 각각 묶음)
              ┌───────────┐
[ACC_IN] ──┬──┤1_1     2_1├──┬── [ACC_FUSED]
           └──┤1_2     2_2├──┘
              └───────────┘

[ACC_FUSED] ──┬── D2   1.5KE22CA bidirectional ── GND   ← D1 앞, 음(−) 서지에서 D1 보호
              └── D1 pin 2 (A)

D1  SB360  (Device:D → 1 = K, 2 = A)
[ACC_FUSED] ──── 2 A ──|>|── K 1 ──── [VIN_PROTECTED]

[VIN_PROTECTED] ──┬── C1   22µF/50V  (+) ────── (−) ── GND
                  ├── C2   100nF/50V X7R ──────────── GND
                  ├── TP1
                  └── U1 pin 1 (+VIN)

U1  TRACO TSR 1-2450 (SIP-3)
                   ┌────────────────────┐
[VIN_PROTECTED] ───┤1 +VIN              │
            GND ───┤2 GND       +VOUT 3 ├─── [+5V]
                   └────────────────────┘

[+5V] ──┬── C3   10µF/16V X7R ── GND
        ├── TP2
        └── U2 pin 1 (IN)

GND ──── TP4

C1은 극성 부품입니다: + → VIN_PROTECTED, − → GND. D2는 ACC_FUSED ↔ GND 병렬 TVS이며 직렬로 넣지 않습니다.

D2 위치 확정 (결정 로그 #14): D2는 D1 앞(ACC_FUSED)에 둡니다. 양방향 TVS가 음(−) 서지를 약 −30V로 클램프해 D1(SB360, 역내압 60V)과 그 뒤 C1·U1을 보호합니다. 배터리 역결선(−12V)에서는 TVS가 도통하지 않고 D1이 차단합니다.

2.2 U2 TPS7B8333 — 3.3V LDO

U2  TPS7B8333QDCYRQ1 (SOT-223 DCY)
          ┌───────────────────┐
[+5V] ────┤1 IN         OUT 3 ├──── [+3.3V]
  GND ────┤2 GND              │
  GND ────┤4 TAB = GND        │      ← 4번(TAB)은 GND. OUT에 연결 금지
          └───────────────────┘

[+5V] ──── C4   1µF/16V X7R ── GND            ← U2 1번 핀 가까이

[+3.3V] ──┬── C5   10µF/16V X7R ── GND
          ├── C6   10µF/16V X7R ── GND        ← C5와 병렬
          └── TP3  (Value +3.3V_TP)

C5/C6은 모두 FIT입니다. MLCC의 DC bias 이후 실효 용량이 LDO 최소 안정 조건을 만족하는지 부품 선정 시 확인하세요.

## 3. 동축 입력·VREF·Comparator

3.1 J1 — 75Ω 동축 입력과 AC coupling

J1  KH-BNC75-3511
┌────────────┐
│ 1 CENTER   ├──── [COAX_SPDIF]
│ 2 SHIELD   ├──── GND
└────────────┘

[COAX_SPDIF] ──┬── R1   75Ω 1% ──────────── GND           ← 75Ω 종단, 커넥터 바로 옆
               ├── TP5
               └── C9   10nF/50V X7R ────── [SPDIF_AC]    ← 직렬 AC coupling, FIT

[SPDIF_AC] ──┬── U3 pin 3 (IN+)
             ├── R2   2.2kΩ 1% ── [VREF]
             ├── TP6
             └── R6   TBD  DNP ── [CMP_OUT]                ← 선택 사항, 0Ω 금지

R1은 75Ω 종단입니다. C9는 직렬 AC coupling이며 DNP가 아니라 FIT입니다.

3.2 VREF와 U3 TLV3601-Q1

[+3.3V] ── R3   2.2kΩ 1% ──┐
                           ├──── [VREF]          ← 공칭 1.65V
    GND ── R4   2.2kΩ 1% ──┘

[VREF] ──┬── C10  1µF/16V X7R ── GND
         ├── R2   2.2kΩ 1% ── [SPDIF_AC]
         └── U3 pin 4 (IN−)

U3  TLV3601QDBVRQ1 (SOT-23-5)
             ┌───────────────────┐
[SPDIF_AC] ──┤3 IN+        OUT 1 ├──── [CMP_OUT]
    [VREF] ──┤4 IN−              │
   [+3.3V] ──┤5 VCC              │
       GND ──┤2 VEE              │
             └───────────────────┘

[+3.3V] ──── C7   100nF/16V X7R ── GND         ← U3 5번 핀 바로 옆

VREF는 공칭 1.65V입니다. AC coupling과 mid-supply bias는 대안이 아니라 함께 사용하는 구성입니다. 입력 부재 감지 회로나 추가 threshold offset을 넣지 않습니다.

3.3 U3 출력 → U4 DI

[CMP_OUT] ──┬── R5   0Ω (opt. 22Ω) ── [DI] ──┬── U4 pin 1 (DI)
            ├── TP7                          └── TP8
            └── R6   TBD  DNP ── [SPDIF_AC]       ← 선택 사항, 0Ω 금지

R6 R_HYS는 DNP · TBD. 그린다면 CMP_OUT ↔ SPDIF_AC에만 연결하고 VREF 등 다른 노드에는 연결하지 마세요. 0Ω 실장 금지.

## 4. U4 MAX3295 전원·Enable·출력

4.1 U4 전원과 DE

U4  MAX3295AUT+T (SOT-23-6)
            ┌───────────────────┐
     [DI] ──┤1 DI           Y 6 ├──── [Y_RAW]
  [+3.3V] ──┤2 VCC          Z 4 ├──── [Z_RAW]
     [DE] ──┤3 DE               │
      GND ──┤5 GND              │
            └───────────────────┘

[+3.3V] ──── R16  0Ω ── [DE] ── TP9            ← DE 항상 High, RC 지연 금지
[+3.3V] ──── C8   100nF/16V X7R ── GND         ← U4 2번 핀 바로 옆
[Y_RAW] ──── TP10
[Z_RAW] ──── TP11

초기 Rev.1은 DE를 R16 0Ω을 통해 항상 HIGH로 둡니다. 임의의 RC delayed-enable 회로를 추가하지 않습니다.

4.2 120Ω 직렬저항과 극성 선택 매트릭스

[Y_RAW] ── R7   120Ω 1% ──┬── R10  0Ω  FIT ── [PAIR_P]
                          └── R12  0Ω  DNP ── [PAIR_N]

[Z_RAW] ── R8   120Ω 1% ──┬── R13  0Ω  DNP ── [PAIR_P]
                          └── R11  0Ω  FIT ── [PAIR_N]

설정 | FIT | DNP | 결과
기본/순정 극성 | R10 + R11 | R12 + R13 | Y→SPDIF+, Z→SPDIF−
반전 시험 | R12 + R13 | R10 + R11 | Y→SPDIF−, Z→SPDIF+

R10~R13을 모두 실장하면 안 됩니다. 극성 변경은 ACC OFF 상태에서 수행하세요.

## 5. CMC·출력 종단·EMC·J2

5.1 FL1 CMC와 우회 점퍼

FL1  ACM2012-900-2P-T001
            ┌─────────────────────┐
[PAIR_P] ───┤1 ═══ Line 1 ═══   4 ├─── [SPDIF_P]
[PAIR_N] ───┤2 ═══ Line 2 ═══   3 ├─── [SPDIF_N]
            └─────────────────────┘

[PAIR_P] ──── R14  0Ω  DNP ──── [SPDIF_P]      ← FL1 1↔4 우회, FL1 제거 시에만
[PAIR_N] ──── R15  0Ω  DNP ──── [SPDIF_N]      ← FL1 2↔3 우회, FL1 제거 시에만
- 금지: FL1 1↔3 또는 2↔4 연결 → SPDIF_P/SPDIF_N 단락
- 초기 상태: FL1 FIT, R14/R15 DNP
- CMC 제거 직결 시험: FL1 DNP, R14/R15 FIT
- FL1과 우회 점퍼를 기본 병렬 연결로 함께 실장하지 않습니다.
- 두 채널을 잘못 연결해 SPDIF_P와 SPDIF_N을 단락시키지 않도록 실제 권선·패드 매핑을 확인합니다.

5.2 출력 종단·EMC 커패시터·J2

[SPDIF_P] ── R9   56Ω 1%  FIT ── [SPDIF_N]     ← FL1 뒤, 커넥터 쪽
[PAIR_P]  ── C11  TBD  DNP ────── [PAIR_N]
[SPDIF_P] ── C12  TBD  DNP ────── [SPDIF_N]
[SPDIF_P] ── C13  TBD  DNP ────── GND
[SPDIF_N] ── C14  TBD  DNP ────── GND

J2  3-pin XH                               ← 결정 로그 #23: 1=SP−, 2=SP+, GND 마지막
┌────────────┐
│ 1  SPDIF−  ├──── [SPDIF_N] ── TP13     ← 꼬임쌍
│ 2  SPDIF+  ├──── [SPDIF_P] ── TP12     ← 꼬임쌍
│ 3  GND     ├──── GND                   ← 검정
└────────────┘

R9는 CMC 뒤 AMP 쪽 차동선 사이의 FIT 부품입니다. C11~C14는 모두 병렬 분기이므로 DNP여도 신호 경로는 유지됩니다.

5.3 전체 신호·전원 흐름 요약

전원
[ACC_IN] → F1 → [ACC_FUSED] → D1 → [VIN_PROTECTED] → U1 → [+5V] → U2 → [+3.3V]
                 └ D2 → GND           └ C1 · C2 → GND

입력
J1 → [COAX_SPDIF] → C9 → [SPDIF_AC] → U3 IN+ → [CMP_OUT] → R5 → [DI] → U4
      └ R1 75Ω → GND    └ R2 → [VREF] = U3 IN−  (R3 · R4 · C10)

출력
U4 Y → [Y_RAW] → R7 → R10 → [PAIR_P] → FL1 1→4 → [SPDIF_P] → J2 SPDIF+
U4 Z → [Z_RAW] → R8 → R11 → [PAIR_N] → FL1 2→3 → [SPDIF_N] → J2 SPDIF−
                                                   R9 56Ω: SPDIF_P ↔ SPDIF_N

## 6. ERC 전 수동 점검

아래 체크는 별도로 저장되지만 부품 배치 진행률 54개에는 포함하지 않습니다.

- U1: 1=+VIN, 2=GND, 3=+VOUT
- U2: 1=IN, 2=GND, 3=OUT, 4=TAB=GND
- U3: 1=OUT, 2=GND, 3=IN+, 4=IN−, 5=VCC
- U4: 1=DI, 2=VCC, 3=DE, 4=Z, 5=GND, 6=Y
- D1: A=ACC_FUSED, K=VIN_PROTECTED
- D2는 ACC_FUSED ↔ GND(D1 앞), C1·C2는 VIN_PROTECTED ↔ GND(D1 뒤) 병렬
- C1 전해커패시터 극성 확인
- C7/C8은 U3/U4 전원 핀 바로 옆에 배치
- R1 75Ω은 BNC 입력에서 GND로 종단
- VREF는 R3/R4로 생성하고 R2/C10/U3 IN−에 연결
- R6은 DNP·TBD이며, 연결했다면 CMP_OUT ↔ SPDIF_AC뿐 (0Ω 아님)
- 기본 극성은 R10/R11만 FIT, R12/R13은 DNP
- FL1 FIT 시 R14/R15는 DNP. R14 = FL1 1↔4, R15 = FL1 2↔3
- R9 56Ω은 CMC 뒤 SPDIF_P ↔ SPDIF_N에 FIT
- C11~C14는 모두 DNP
- J3 1=ACC_IN, 2=GND · J2 1=SPDIF_N, 2=SPDIF_P, 3=GND (결정 #23, GND 마지막)
- D1 Device:D: 1=K → VIN_PROTECTED, 2=A → ACC_FUSED
- F1 1_1+1_2 묶음, 2_1+2_2 묶음
- PWR_FLAG: VIN_PROTECTED, +3.3V(U2 OUT 핀 타입이 output), 필요 시 GND
- ERC 후 넷리스트로 핀 단위 대조 (겹친 라벨 단락은 ERC 경고로만 나올 수 있음)

## 7. PCB 풋프린트 확정 전에 남은 결정

1. J2 XH 계열 커넥터의 정확한 MPN과 2.50/2.54mm pitch
2. C1의 실제 MPN, 직경, 리드 간격, 높이
3. 일반 저항과 MLCC의 구매 MPN 및 DC bias 실효 용량
4. D1/D2의 리드 성형 간격과 패드 간격
5. U1 TRACO 모듈의 방향, 높이, 핀 간격
6. J1 BNC와 FH1 퓨즈홀더의 실제 패드 번호·기구 치수
7. FL1 CMC land pattern 실물 대조 (풋프린트·권선 매핑은 결정 로그 #2·#3에서 확정)
8. 케이스 납입, 커넥터 방향, 테스트포인트 접근성

이 항목들은 회로도 작업을 막지 않지만 PCB 풋프린트 lock과 제조 전에는 반드시 해결해야 합니다.

DUDU7 / FYT7862 → Hyundai i40 OEM AMP S/PDIF TX Rev.1 · 회로도 작업 가이드 · 제조 승인 문서 아님
