gvsolgryn/HYK_AMP_Converter/HYK_AMP_Converter.kicad_pcb

## KiCad design HYK_AMP_Converter.kicad_pcb (2026-11-13)

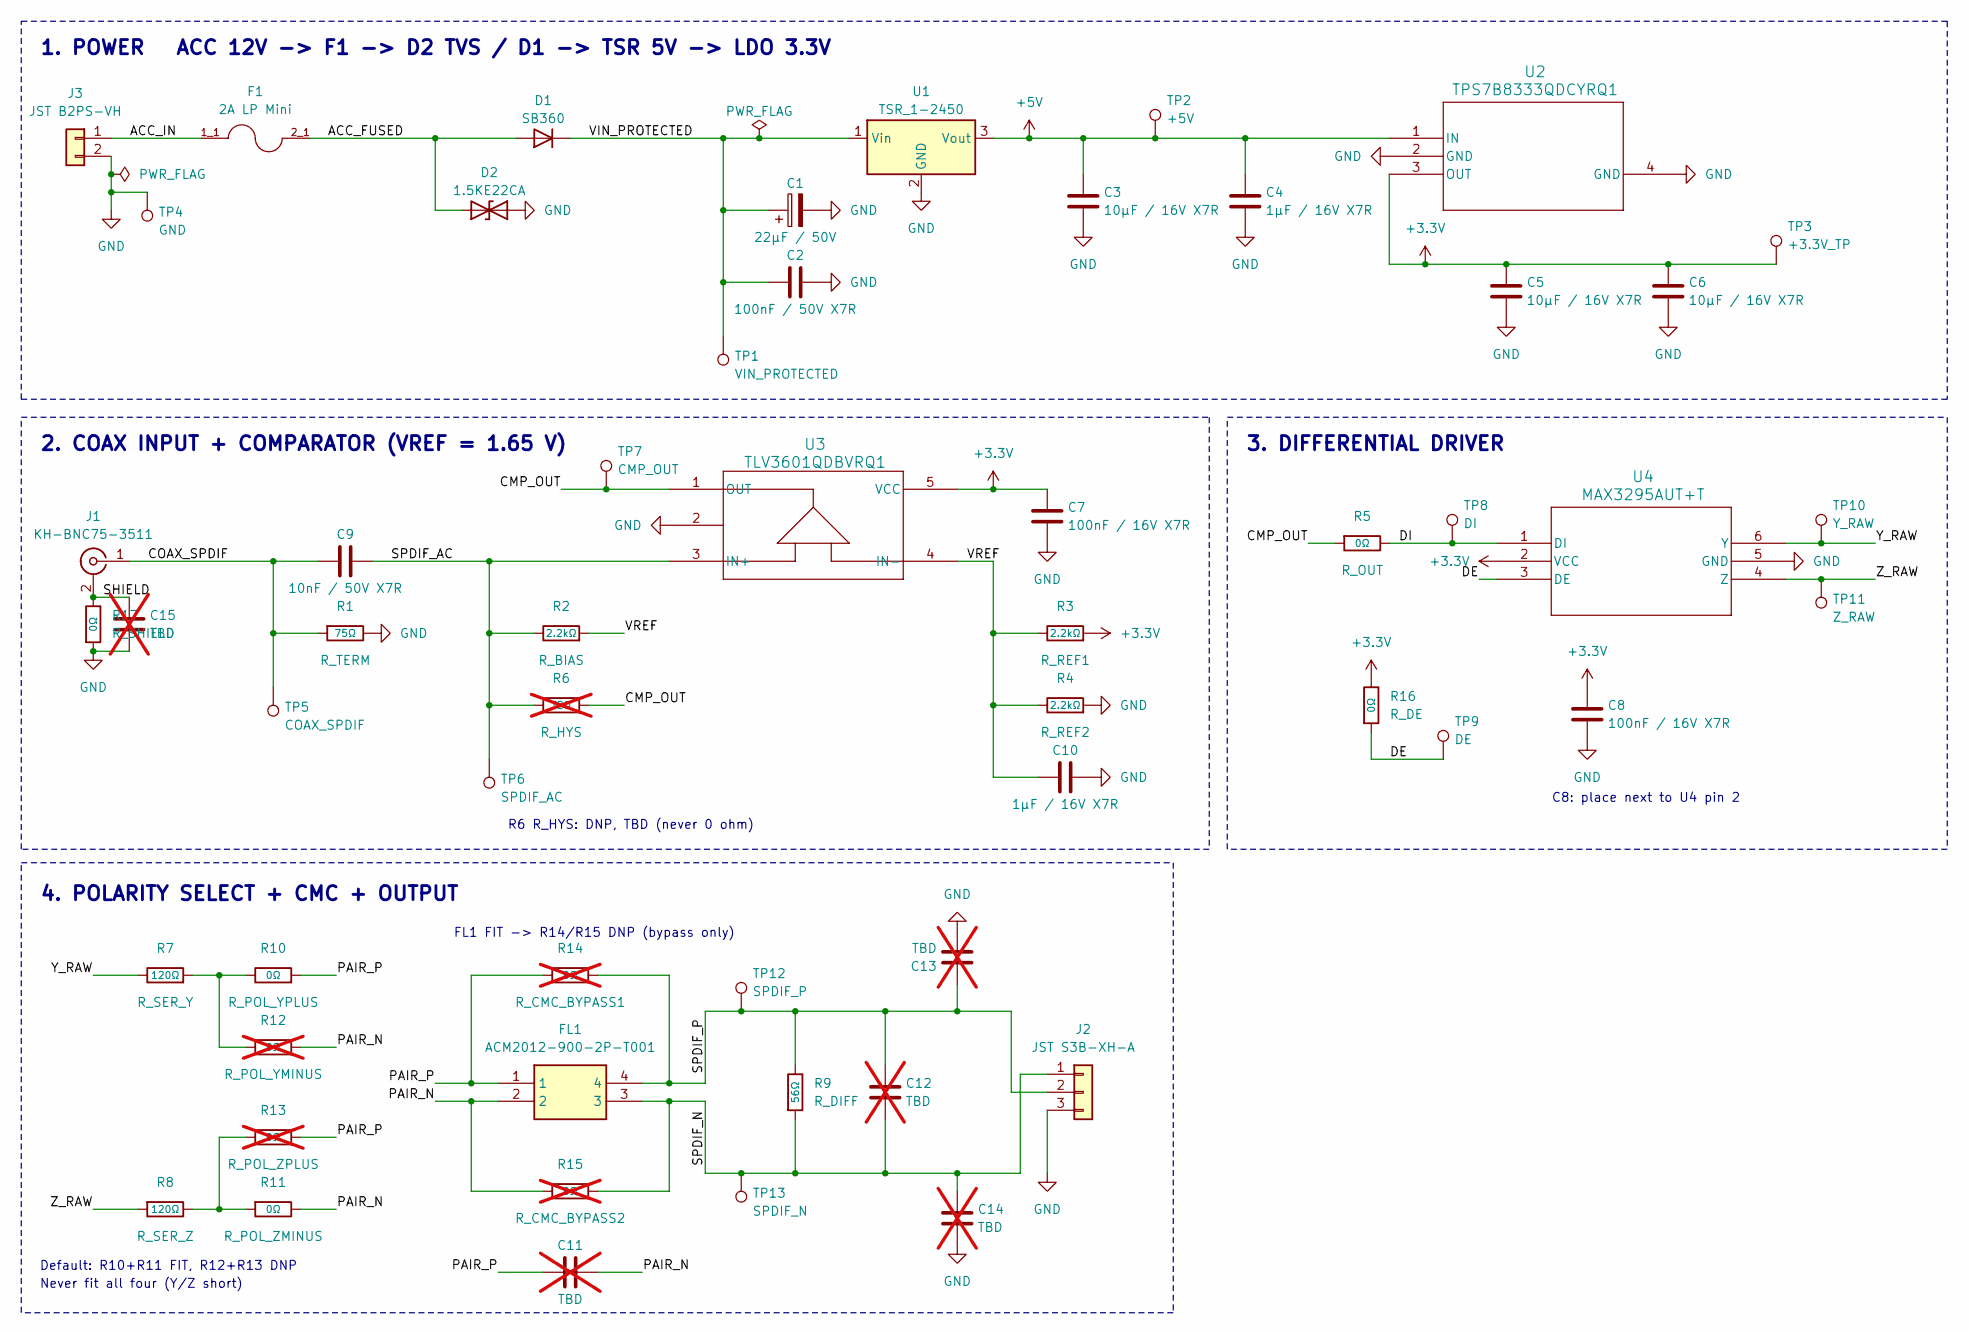
[picture p1: schematic HYK_AMP_Converter.kicad_sch]

Parts:
C1: 22µF / 50V; CP_Radial_D5.0mm_P2.00mm; MPN EEU-FR1H220
C2: 100nF / 50V X7R; C_0805_2012Metric_Pad1.18x1.45mm_HandSolder
C3, C5, C6: 10µF / 16V X7R; C_0805_2012Metric_Pad1.18x1.45mm_HandSolder
C4, C10: 1µF / 16V X7R; C_0805_2012Metric_Pad1.18x1.45mm_HandSolder
C7, C8: 100nF / 16V X7R; C_0805_2012Metric_Pad1.18x1.45mm_HandSolder
C9: 10nF / 50V X7R; C_0805_2012Metric_Pad1.18x1.45mm_HandSolder
C11, C12, C13, C14, C15: TBD; C_0805_2012Metric_Pad1.18x1.45mm_HandSolder; not fitted
D1: SB360; P2_DO-201
D2: 1.5KE22CA; D_DO-201AE_P15.24mm_Horizontal
F1: 2A LP Mini; FUSE_3557-2; MPN 3557-2
FL1: ACM2012-900-2P-T001; ACM20121022PT001; MPN ACM2012-900-2P-T001
J1: KH-BNC75-3511
J2: JST S3B-XH-A; JST_XH_S3B-XH-A_1x03_P2.50mm_Horizontal_Drill1.0
J3: JST B2PS-VH; JST_VH_B2PS-VH_1x02_P3.96mm_Horizontal
R1: 75Ω; R_0805_2012Metric_Pad1.20x1.40mm_HandSolder
R2, R3, R4: 2.2kΩ; R_0805_2012Metric_Pad1.20x1.40mm_HandSolder
R5, R10, R11, R16, R17: 0Ω; R_0805_2012Metric_Pad1.20x1.40mm_HandSolder
R6: TBD; R_0805_2012Metric_Pad1.20x1.40mm_HandSolder; not fitted
R7, R8: 120Ω; R_0805_2012Metric_Pad1.20x1.40mm_HandSolder
R9: 56Ω; R_0805_2012Metric_Pad1.20x1.40mm_HandSolder
R12, R13, R14, R15: 0Ω; R_0805_2012Metric_Pad1.20x1.40mm_HandSolder; not fitted
TP1: VIN_PROTECTED; TestPoint_Pad_D1.5mm
TP2: +5V; TestPoint_Pad_D1.5mm
TP3: +3.3V_TP; TestPoint_Pad_D1.5mm
TP4: GND; TestPoint_Pad_D1.5mm
TP5: COAX_SPDIF; TestPoint_Pad_D1.5mm
TP6: SPDIF_AC; TestPoint_Pad_D1.5mm
TP7: CMP_OUT; TestPoint_Pad_D1.5mm
TP8: DI; TestPoint_Pad_D1.5mm
TP9: DE; TestPoint_Pad_D1.5mm
TP10: Y_RAW; TestPoint_Pad_D1.5mm
TP11: Z_RAW; TestPoint_Pad_D1.5mm
TP12: SPDIF_P; TestPoint_Pad_D1.5mm
TP13: SPDIF_N; TestPoint_Pad_D1.5mm
U1: TSR_1-2450; Converter_DCDC_TRACO_TSR-1_THT
U2: TPS7B8333QDCYRQ1; SOT_8350QDCYRQ1_TEX-L
U3: TLV3601QDBVRQ1; SOT_DBVRQ1_TEX-L
U4: MAX3295AUT+T; 21-0058_U6CN-2_MXM-L

Connections:
+3.3V: C5.1, C6.1, C7.2, C8.1, R3.2, R16.1, TP3.1 (1_1), U2.3 (OUT), U3.5 (VCC), U4.2 (VCC)
+5V: C3.1, C4.2, TP2.1 (1_1), U1.3 (Vout), U2.1 (IN)
/ACC_FUSED: D1.2 (A), D2.1 (A1), F1.2_1, F1.2_2
/ACC_IN: F1.1_1, F1.1_2, J3.1
/CMP_OUT: R5.2, R6.2, TP7.1 (1_1), U3.1 (OUT)
/COAX_SPDIF: C9.2, J1.1 (In), R1.2, TP5.1 (1_1)
/DE: R16.2, TP9.1 (1_1), U4.3 (DE)
/DI: R5.1, TP8.1 (1_1), U4.1 (DI)
/PAIR_N: C11.1, FL1.2, R11.1, R12.2, R15.1
/PAIR_P: C11.2, FL1.1, R10.2, R13.2, R14.1
/SHIELD: C15.1, J1.2 (Ext), R17.1
/SPDIF_AC: C9.1, R2.1, R6.1, TP6.1 (1_1), U3.3 (IN+)
/SPDIF_N: C12.2, C14.1, FL1.3, J2.1, R9.2, R15.2, TP13.1 (1_1)
/SPDIF_P: C12.1, C13.1, FL1.4, J2.2, R9.1, R14.2, TP12.1 (1_1)
/VIN_PROTECTED: C1.1, C2.1, D1.1 (K), TP1.1 (1_1), U1.1 (Vin)
/VREF: C10.1, R2.2, R3.1, R4.1, U3.4 (IN-)
/Y_RAW: R7.1, TP10.1 (1_1), U4.6 (Y)
/Z_RAW: R8.2, TP11.1 (1_1), U4.4 (Z)
GND: C1.2, C2.2, C3.2, C4.1, C5.2, C6.2, C7.1, C8.2, C10.2, C13.2, C14.2, C15.2, D2.2 (A2), J2.3, J3.2, R1.1, R4.2, R17.2, TP4.1 (1_1), U1.2 (GND), U2.2 (GND), U2.4 (GND), U3.2, U4.5 (GND)
unnamed: R7.2, R10.1, R12.1
unnamed: R8.1, R11.2, R13.1

Notes on the sheet:
4. POLARITY SELECT + CMC + OUTPUT
2. COAX INPUT + COMPARATOR (VREF = 1.65 V)
3. DIFFERENTIAL DRIVER
R6 R_HYS: DNP, TBD (never 0 ohm)
Never fit all four (Y/Z short)
C8: place next to U4 pin 2
Default: R10+R11 FIT, R12+R13 DNP
1. POWER ACC 12V -> F1 -> D2 TVS / D1 -> TSR 5V -> LDO 3.3V
FL1 FIT -> R14/R15 DNP (bypass only)

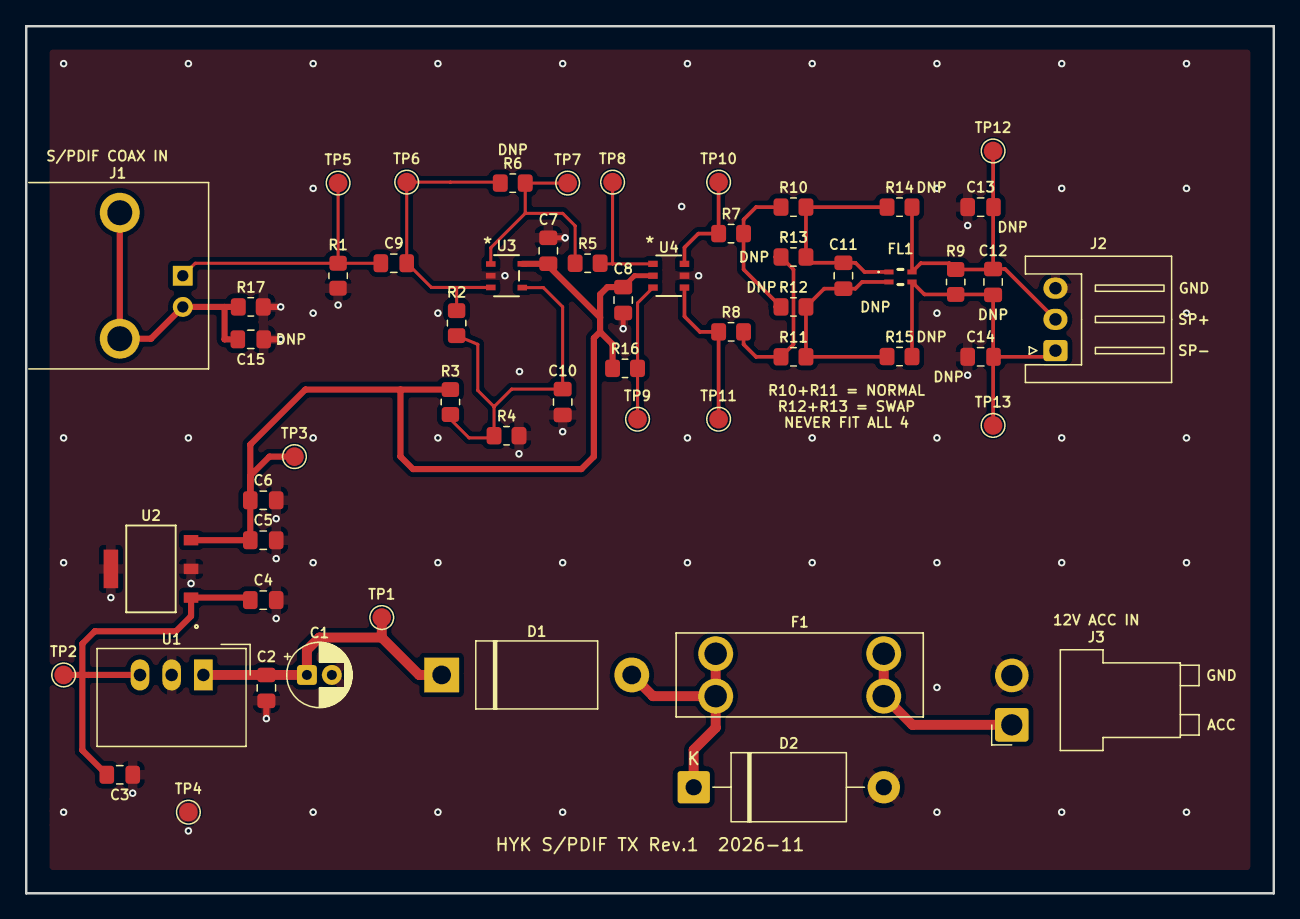
[picture p2: board HYK_AMP_Converter.kicad_pcb from above]

Board: 2 copper layers, 100.0 x 69.5 mm, 57 parts (0 on the bottom side), 21 nets.

Other parts of the board:
MECH1: CASE_RT7511
