gvsolgryn/HYK_AMP_Converter/(commit log)

2026-10-23 Initial commit: DUDU7-i40 S/PDIF 변환기 KiCad 프로젝트 기반 구성
    - Rev.A2 기준 회로도 (U1~U4 배치: TPS7B8333, TLV3601-Q1, MAX3295, LMR16006YQ5)
    - 프로젝트 내장 UL 심볼/풋프린트 라이브러리 + sym-lib-table/fp-lib-table (클론 즉시 사용)
    - 설계 사양 문서 docs/ (Rev.A 20261015, Rev.A2 20261016)
    - 핀아웃 검증용 제조사 데이터시트 references/datasheets/
    - README.md, AGENTS.md (한국어), .gitignore, opencode.json (kicad-mcp-pro MCP)
2026-11-11 Add Rev.1 schematic guide and component libraries
2026-11-11 Document Rev.1 symbol footprint audit
2026-11-12 Save current Rev.1 schematic work
2026-11-12 Rev.1 schematic: place all parts, fix D1 polarity, record decisions
    - Place R1-R16, C1-C14, TP1-TP13, J1-J3, FL1; resistor Value=value, Description=role, Value inside body
    - D1 symbol Device:D to match SB360 footprint (pad1=K); C1 polarized; U2-U4 -L footprints
    - FL1 uses ACM2012H footprint (matches TDK land pattern); drop mismatched ACM2012-900-2P-T001 library
    - DNP: R6, R12-R15, C11-C14; TP footprints TestPoint_Pad_D1.5mm
    - Add ACM2012H library and datasheets (ACM2012, BNC, LP Mini fuse, JST VH/XH, TSR1)
    - Ignore backup/, output/, .kicad-mcp/
    - AGENTS.md updated for Rev.1; BOM decision log 2026-11-12
2026-11-12 Rev.1 schematic wired (ERC 0), enclosure RT-75, PCB handoff docs
    Schematic
    - All 54 Rev.1 parts wired; netlist checked pin by pin, ERC 0
    - D2 TVS moved ahead of D1 on ACC_FUSED (decision #14)
    - J2/J3 pin order: name order, GND last (decision #15)
    - U2/U4 project symbols: fix pin electrical types; PWR_FLAG on
    VIN_PROTECTED and GND
    - Layout reorganised into 4 blocks (power/input/driver/output),
    local labels between blocks; netlist unchanged
    Mechanical
    - Enclosure: CaseForU RT-7511 (75 x 30.9 x 110); PCB outline
    69.5 x 107.0 (decision #16)
    - J1 BNC thread passes through the front panel, nut fixed (#17)
    - Case drawings kept local only (references/case_file/ ignored:
    vendor no-redistribu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
2026-11-12 Docs: move superseded docs to docs/archive, fold still-valid Rev.A2 content into the PCB handoff (section 8)
2026-11-13 PCB 69.5x100 (JLCPCB special price), J1 KH-BNC75-3511 footprint, D1 drill 1.5
    - Decision #18: PCB outline 69.5 x 100.0 mm (JLCPCB special price <= 102 x 102), rear 7 mm free
    - Decision #19: new J1 footprint from Kinghelm drawing KH-801-0039 rev B; SB360 drill 1.3 -> 1.5 mm
    - AGENTS/README/handoff updated
2026-11-13 F1 3557-2 drill 1.6 -> 1.8 mm; J1 uses KH-BNC75-3511 footprint; add Diotec SB320-SB360 datasheet
    - F1: blade 1.57 x 0.40 (diagonal 1.62) vs Keystone min hole 1.60
    - J1 Footprint field changed by user in KiCad
    - ignore KiCad *.bak
2026-11-13 C1 = Panasonic EEU-FR1H220 (CP_Radial_D5.0mm_P2.00mm); SB360 multi-source note (decision #20)
2026-11-13 J2: project XH footprint with 1.0 mm drill (decision #21)
2026-11-13 J1 GND-lead side verified against drawing front/rear/PCB views
2026-11-13 Schematic BOM fields: C5/C6 value, FL1 TDK fields, F1 holder+fuse fields (decision #22)
2026-11-13 User layout tweaks after BOM field cleanup (netlist unchanged, ERC 0); BOM field list in project
2026-11-13 J2 pin order 1=SPDIF-, 2=SPDIF+, 3=GND for straight routing (decision #23)
2026-11-13 PCB: import from schematic, outline 100x69.5 R1, draft placement per plan; J1 courtyard single outline
2026-11-13 Case RT-7511: STEP-measured keep-outs in handoff, CASE_RT7511 3D/keep-out reference footprint
2026-11-13 PCB: place locked CASE_RT7511 reference (MECH1), register Case_RT75 lib, J1 courtyard synced with library (DRC: only silk warnings)
2026-11-13 Board setup: JLCPCB rules, copper-edge 2.0 mm, net classes Power12/Rail/GND/SPDIF_OUT with patterns, predefined tracks/vias
2026-11-13 PCB text tidy: F.Fab ref centred/value below body, silk refs moved clear of pads/courtyards (DRC: only 2 lib pin-1 marker overlaps)
2026-11-13 PCB: GND stitching (17 pad + 44 grid vias), Net-(R11-Pad2) on F.Cu only, TP2 edge clearance, DNP silk marks; DRC clean except 2 lib pin-1 silk overlaps
2026-11-13 EMI: C7/C8 next to U3/U4 VCC (1.9/2.8 mm), VREF and +3.3V on F.Cu only (no B.Cu cuts), R2 moved below U3, CMP_OUT rerouted; DRC clean
2026-11-13 C2 on U1-C1 VIN trace (5 mm from U1 pin 1, GND via), VIN from D1 routed above C1; DRC clean
2026-11-13 PCB layout done (DRC 0, parity 0): pin-1 marker cleanup; docs updated with PCB status and decision #24
2026-11-13 J1 shield on /SHIELD via R17 0R || C15 DNP (decision #25), silkscreen labels, U3/U4 lib pin-1 marker dedupe; ERC/DRC/parity 0
